devtomar77t/Project-X-Selection-Tasks/Line-Maze-Solver/lms_repo/Extras/Webots/bot_image.png

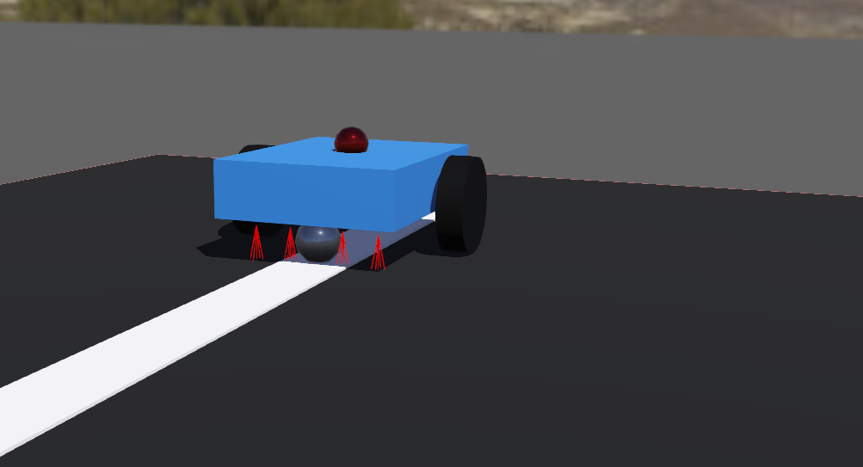
Line-Maze-Solver/lms_repo/Extras/Webots/bot_image.png
