devtomar77t/Project-X-Selection-Tasks/Line-Maze-Solver/lms_repo/BOM/BOM.csv

# | Category | Item / exact model | Qty | Unit INR | Line INR | Price basis | Supplier | Link
1 | Controller | ESP32 DevKit V1, 30-pin (ESP32-WROOM-32) | 1 | 450 | 450 | est. (seen Rs289-559) | Robu / Flyrobo | https://robu.in/?s=ESP32+DevKit+V1&post_type=product
2 | Motor driver | Toshiba TB6612FNG dual MOSFET H-bridge module | 1 | 180 | 180 | est. (seen Rs149-220) | Robu | https://robu.in/?s=TB6612FNG&post_type=product
3 | Motors | N20 6 V 600 RPM micro metal gear motor | 2 | 340 | 680 | est. | Robu | https://robu.in/?s=N20+6V+600+RPM&post_type=product
4 | Motor mounts | Mounting bracket for N20 motors (pack of 2) | 1 | 35 | 35 | robu page | Robu | https://robu.in/?s=N20+mounting+bracket&post_type=product
5 | Wheels | 44 mm 'miniQ' rubber tyre wheel for N20 | 2 | 67 | 134 | robu page (Rs57-67) | Robu | https://robu.in/?s=miniQ+wheel+44mm+N20&post_type=product
6 | Caster | Metal ball caster (front support) | 1 | 60 | 60 | est. | Robu | https://robu.in/?s=ball+caster&post_type=product
7 | Battery | Orange 7.4 V 1000 mAh 40C 2S LiPo (55 g) | 1 | 750 | 750 | est. | Robu | https://robu.in/?s=7.4V+1000mAh+2S+LiPo&post_type=product
8 | Charger | iMAX B6-class balance charger (2S-6S) | 1 | 1800 | 1800 | est. (SkyRC B6AC V2 = Rs4017 on Robu) | Robu | https://robu.in/?s=imax+b6+charger&post_type=product
9 | Battery safety | LiPo low-voltage alarm / cell checker (2S-8S) | 1 | 100 | 100 | est. | Robu | https://robu.in/?s=lipo+voltage+alarm&post_type=product
10 | Battery safety | LiPo battery strap, 30 cm | 1 | 53 | 53 | robu page | Robu | https://robu.in/?s=lipo+battery+strap&post_type=product
11 | 5 V supply | MP1584EN mini buck converter module (set to 5.0 V) | 1 | 80 | 80 | est. | Robu / ElectronicsComp | https://robu.in/?s=MP1584EN&post_type=product
12 | Sensors | TCRT5000 reflective IR sensor (bare), 5 + 2 spare | 7 | 18 | 126 | est. | Robu | https://robu.in/?s=TCRT5000&post_type=product
13 | Sensor board | Perfboard 3x7 cm + male header strip | 1 | 60 | 60 | est. | ElectronicsComp | https://www.electronicscomp.com/
14 | Passives | Resistor assortment (220 ohm, 10 k, etc.) | 1 | 100 | 100 | est. | ElectronicsComp | https://www.electronicscomp.com/
15 | Passives | Electrolytic capacitor 470 uF / 25 V | 2 | 12 | 24 | est. | ElectronicsComp | https://www.electronicscomp.com/
16 | Passives | Ceramic capacitor 0.1 uF (104), pack of 10 | 1 | 20 | 20 | est. | ElectronicsComp | https://www.electronicscomp.com/
17 | Passives | 1N5819 Schottky diodes (protection), pack of 8 | 1 | 40 | 40 | est. | ElectronicsComp | https://www.electronicscomp.com/
18 | UI | Red 5 mm LED (END indicator) + status LED, pack of 5 | 1 | 20 | 20 | est. | ElectronicsComp | https://www.electronicscomp.com/
19 | UI | Tactile push-buttons (calibration / run select), pack of 5 | 1 | 25 | 25 | est. | ElectronicsComp | https://www.electronicscomp.com/
20 | Power | Slide / rocker power switch (single start switch) | 2 | 20 | 40 | est. | ElectronicsComp | https://www.electronicscomp.com/
21 | Power | 3 A fuse + inline holder | 1 | 40 | 40 | est. | ElectronicsComp | https://www.electronicscomp.com/
22 | Wiring | Silicone wire 22 AWG red + black, 2 m each | 1 | 120 | 120 | est. | Robu | https://robu.in/?s=silicone+wire+22awg&post_type=product
23 | Wiring | Dupont jumper set (M-F / F-F) | 1 | 130 | 130 | est. | Robu | https://robu.in/?s=dupont+jumper+wire&post_type=product
24 | Connectors | XT30 pair (robot side) + JST-XH 2S balance lead | 1 | 80 | 80 | est. | Robu | https://robu.in/?s=XT30+connector&post_type=product
25 | Connectors | Female header strips (ESP32 & TB6612FNG sockets) | 1 | 30 | 30 | est. | ElectronicsComp | https://www.electronicscomp.com/
26 | Chassis | Custom chassis: 3 mm acrylic laser-cut or PLA 3D print | 1 | 450 | 450 | est. | Local fab / Robu | https://robu.in/?s=acrylic+sheet+3mm&post_type=product
27 | Hardware | M3 screws, nuts, standoffs kit | 1 | 150 | 150 | est. | Robu | https://robu.in/?s=M3+standoff+kit&post_type=product
28 | Hardware | Heat-shrink, double-sided tape, cable ties | 1 | 50 | 50 | est. | Robu | https://robu.in/?s=heat+shrink+tube&post_type=product
 |  | Subtotal |  |  | 5827
 |  | Shipping (2 suppliers + LiPo handling) |  |  | 250
 |  | Contingency 10% of (subtotal+shipping) |  |  | 608
 |  | GRAND TOTAL |  |  | 6685
