devtomar77t/Project-X-Selection-Tasks/(commit log)

2026-10-26 modified BOM folder
    [BOM(1).csv, BOM.csv]
2026-10-26 Added wiring
